hey-frnk/thevfdcollective/FluorescenceCompiled/README.md

# FluorescenceCompiled

Here you will find the latest compiled versions of FluorescenceApp and the firmware of Fluorescence

- FL2:    Fluorescence hardware version 2.x, blue circuit board. Uses Arduino AVR platform, ATmega328P
- FL3:    Fluorescence hardware version 3.x, black circuit board. Uses STM32 platform, STM32L412
