hey-frnk/thevfdcollective/FluorescenceApp/Resources/about.jpg

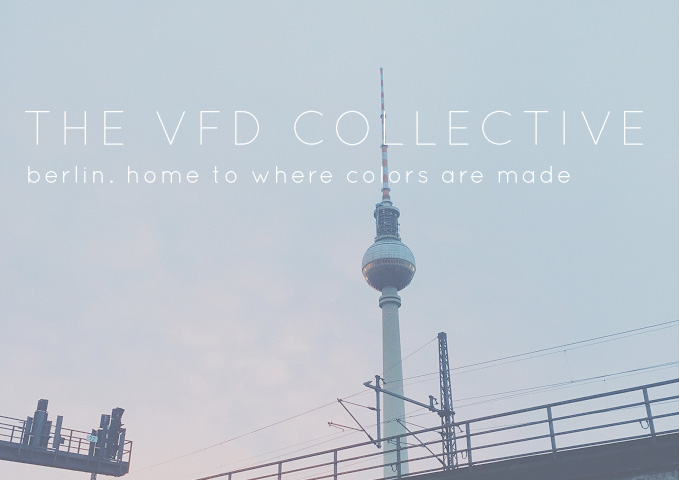
FluorescenceApp/Resources/about.jpg
