hey-frnk/thevfdcollective/FluorescenceApp/Resources/computer.png

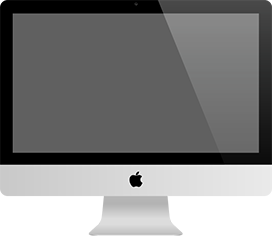
FluorescenceApp/Resources/computer.png
