hey-frnk/thevfdcollective/FluorescenceApp/Resources/fl2_usb.jpg

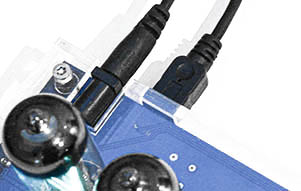
FluorescenceApp/Resources/fl2_usb.jpg
