hey-frnk/thevfdcollective/FluorescenceApp/Resources/fl3_usb.jpg

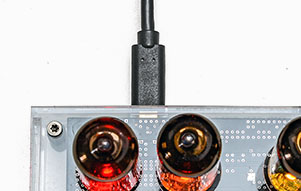
FluorescenceApp/Resources/fl3_usb.jpg
