hey-frnk/thevfdcollective/FluorescenceApp/Resources/menu.png

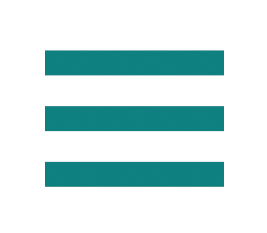
FluorescenceApp/Resources/menu.png
