hey-frnk/thevfdcollective/FluorescenceApp/Resources/menu_inv.png

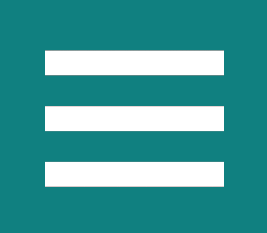
FluorescenceApp/Resources/menu_inv.png
