hey-frnk/thevfdcollective/FluorescenceApp/Resources/pcb.jpg

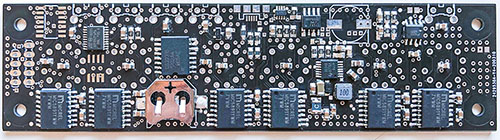
FluorescenceApp/Resources/pcb.jpg
