hey-frnk/thevfdcollective/FluorescenceApp/Resources/reload.png

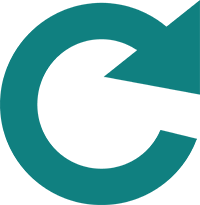
FluorescenceApp/Resources/reload.png
