hey-frnk/thevfdcollective/FluorescenceApp/Resources/res0.jpg

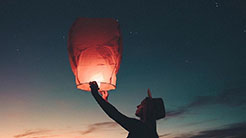
FluorescenceApp/Resources/res0.jpg
