hey-frnk/thevfdcollective/FluorescenceApp/Resources/res1.jpg

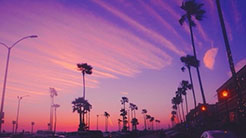
FluorescenceApp/Resources/res1.jpg
