hey-frnk/thevfdcollective/FluorescenceApp/Resources/res2.jpg

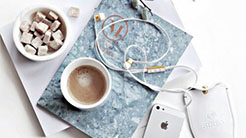
FluorescenceApp/Resources/res2.jpg
