hey-frnk/thevfdcollective/FluorescenceApp/Resources/res3.jpg

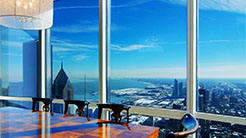
FluorescenceApp/Resources/res3.jpg
