hey-frnk/thevfdcollective/FluorescenceApp/Resources/stop.png

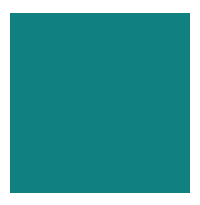
FluorescenceApp/Resources/stop.png
