hey-frnk/thevfdcollective/openvfd_firmware_resources/fw3_architecture.pdf

## OpenVFD / Fluorescence 3.0 Firmware Architecture

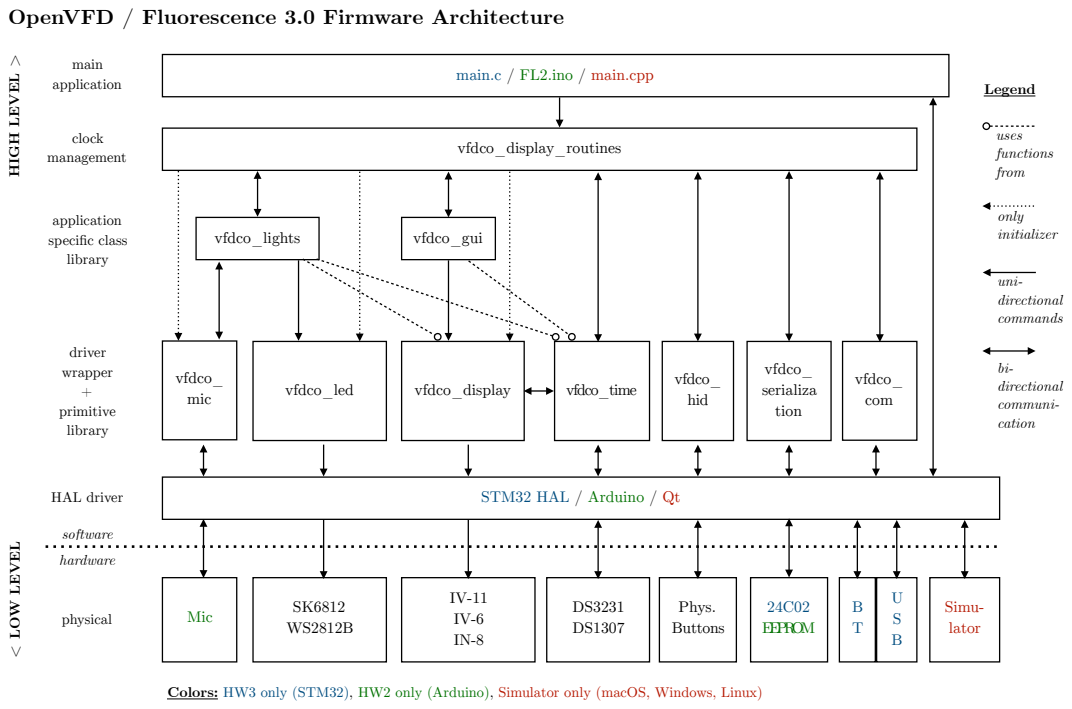
[picture p17: page 1]
vfdco_led; vfdco_display; vfdco_lights; vfdco_gui; vfdco_time; vfdco_; hid; vfdco_display_routines; Phys. Buttons; Simu- lator; vfdco_ com; hardware; software; physical; HAL driver; driver wrapper + primitive library; application specific class library; clock management; main; vfdco_ serializa tion; 24C02 EEPROM; vfdco_ mic; Mic; uses functions from; Legend; only initializer; uni- directional commands; bi- directional communi- cation

HIGH LEVEL > < LOW LEVEL
application

main.c / FL2.ino / main.cpp

STM32 HAL / Arduino / Qt

Colors: HW3 only (STM32), HW2 only (Arduino), Simulator only (macOS, Windows, Linux)
