hey-frnk/thevfdcollective/hardware/eagle_boards/usb_typec_pd_stusb4500.brd

## EAGLE design hardware/eagle_boards/usb_typec_pd_stusb4500.brd (2020-05-08)

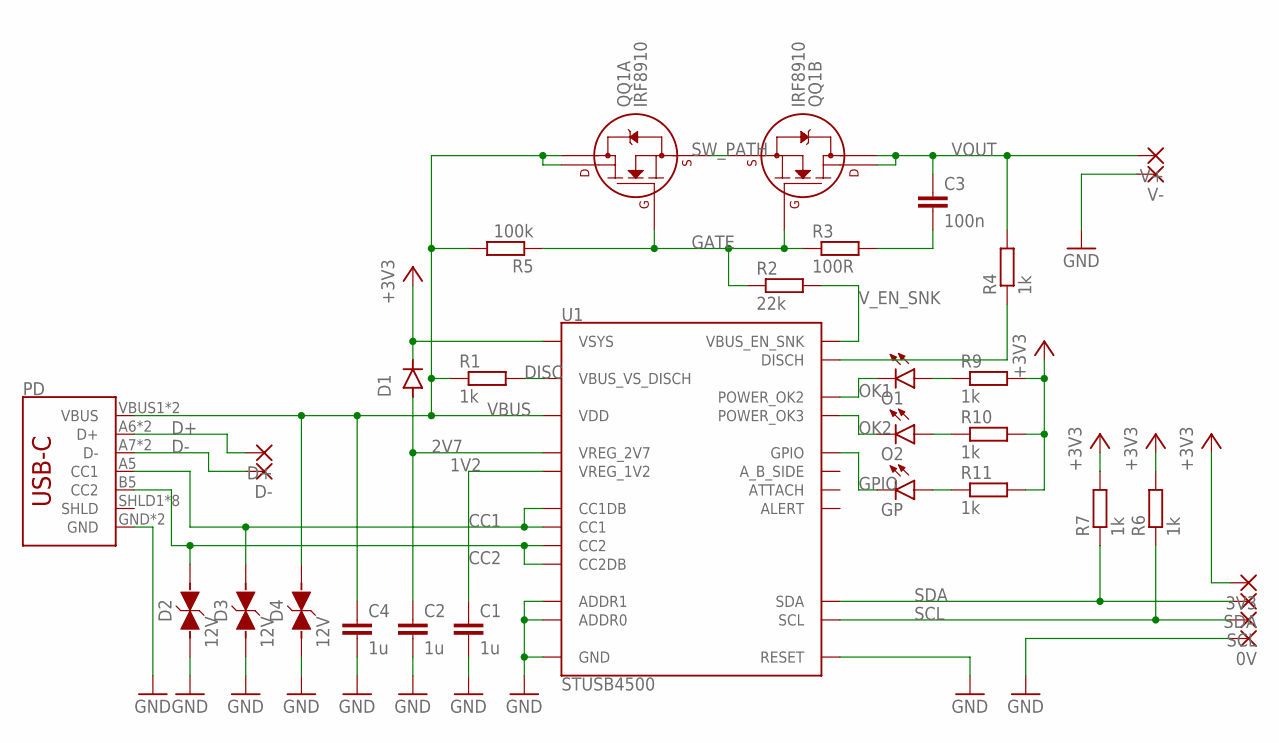
[picture p18: schematic usb_typec_pd_stusb4500.sch]

Parts:
0V, 3V3: SMD2; SMD1,27-2,54
C1, C2, C4: 1u; C0805
C3: 100n; C0805
D1: DIODE-SOD123; SOD123
D2, D3, D4: 12V; WE-VE_0805
D+: SMD2; SMD1,27-2,54
D-: SMD2; SMD1,27-2,54
GP: LEDCHIP-LED0805; CHIP-LED0805
O1, O2: LEDCHIP-LED0805; CHIP-LED0805
PD: USB-TYPEC-16PIN2-LAYER; USB-C-16P
QQ1: IRF8910; SO-8
R1, R4, R6, R7, R9, R10, R11: 1k; R0805
R2: 22k; R0805
R3: 100R; R0805
R5: 100k; R0805
SCL: SMD2; SMD1,27-2,54
SDA: SMD2; SMD1,27-2,54
U1: STUSB4500; POWER-QFN-24
V+: SMD2; SMD1,27-2,54
V-: SMD2; SMD1,27-2,54

Connections:
1V2: C1.1, U1.P$21 (VREG_1V2)
2V7: C2.1, D1.A, U1.P$23 (VREG_2V7)
+3V3: 3V3.1, D1.C, R6.2, R7.2, R9.2, R10.2, R11.2, U1.P$22 (VSYS)
CC1: D3.1, PD.A5 (CC1), U1.P$1 (CC1DB), U1.P$2 (CC1)
CC2: D2.1, PD.B5 (CC2), U1.P$4 (CC2), U1.P$5 (CC2DB)
D+: D+.1, PD.A6 (D+), PD.B6 (D+)
D-: D-.1, PD.A7 (D-), PD.B7 (D-)
DISC: R1.2, U1.P$18 (VBUS_VS_DISCH)
GATE: QQ1.2 (G), QQ1.4 (G), R2.1, R3.1, R5.1
GND: 0V.1, C1.2, C2.2, C4.2, D2.2, D3.2, D4.2, PD.GND, PD.GND2 (GND), U1.P$6 (RESET), U1.P$10 (GND), U1.P$12 (ADDR0), U1.P$13 (ADDR1), U1.P$25 (GND), V-.1
GPIO: GP.C, U1.P$15 (GPIO)
unnamed: C3.2, R3.2
unnamed: R4.1, U1.P$9 (DISCH)
unnamed: O1.A, R9.1
unnamed: O2.A, R10.1
unnamed: GP.A, R11.1
OK1: O1.C, U1.P$20 (POWER_OK2)
OK2: O2.C, U1.P$14 (POWER_OK3)
SCL: R6.1, SCL.1, U1.P$7 (SCL)
SDA: R7.1, SDA.1, U1.P$8 (SDA)
SW_PATH: QQ1.1 (S), QQ1.3 (S)
VBUS: C4.1, D4.1, PD.VBUS1 (VBUS), PD.VBUS2 (VBUS), QQ1.7 (D2), QQ1.8 (D1), R1.1, R5.2, U1.P$24 (VDD)
VOUT: C3.1, QQ1.5 (D2), QQ1.6 (D1), R4.2, V+.1
V_EN_SNK: R2.2, U1.P$16 (VBUS_EN_SNK)

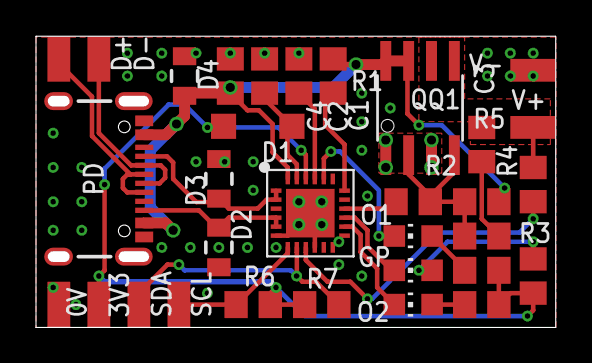
[picture p19: board usb_typec_pd_stusb4500.brd from above]

Board: 2 copper layers, 28.9 x 16.2 mm, 32 parts (0 on the bottom side), 24 nets.
