hey-frnk/thevfdcollective/hardware/eagle_boards/openvfd_ecopower.brd

## EAGLE design hardware/eagle_boards/openvfd_ecopower.brd (2018-04-13)

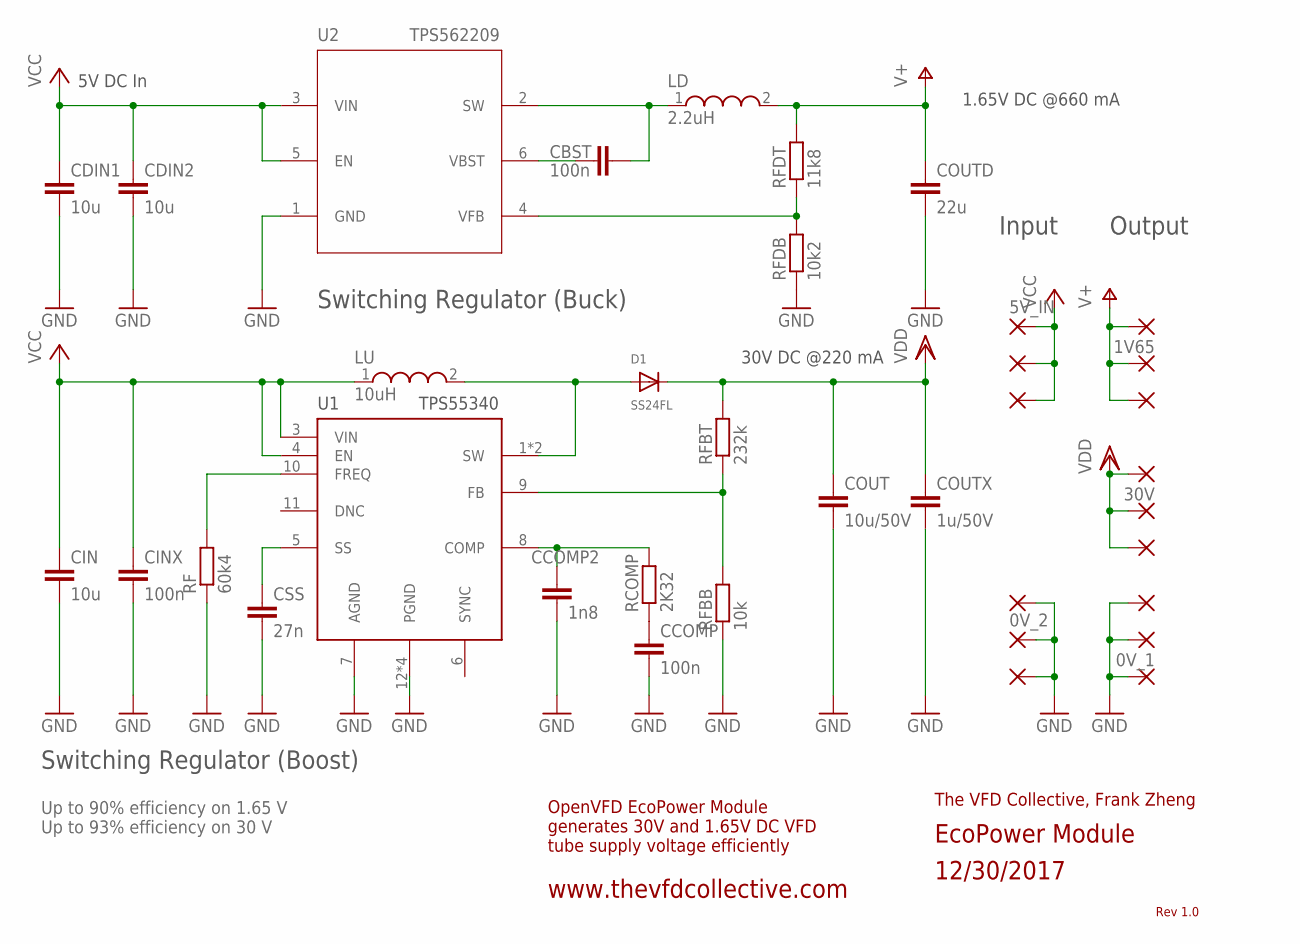
[picture p20: schematic openvfd_ecopower.sch, OpenVFD EcoPower Module]

Parts:
0V_1, 0V_2, 0V_3, 0V_4, 1V1, 1V65, 5V_IN, 5V_IN1, 30V, 30V1: SMD2; SMD1,27-2,54
CBST: 100n; C0805
CCOMP: 100n; C0805
CCOMP2: 1n8; C0805
CDIN1, CDIN2: 10u; C0805
CIN: 10u; C0805
CINX: 100n; C0805
COUT: 10u/50V; C1206
COUTD: 22u; C0805
COUTX: 1u/50V; C0805
CSS: 27n; C0805
D1: SS24FL; SOD-123FL
LD: 2.2uH; WE-TPC_4818/4828
LU: 10uH; WE-LQS_6045
PAD1, PAD2, PAD3, PAD4, PAD5: 1,6/0,8
RCOMP: 2K32; R0805
RF: 60k4; R0805
RFBB: 10k; R0805
RFBT: 232k; R0805
RFDB: 10k2; R0805
RFDT: 11k8; R0805
U1: TPS55340; HTSSOP-14
U2: TPS562209; SOT-23(6)

Connections:
COMP: CCOMP2.1, RCOMP.2, U1.8 (COMP)
FB: RFBB.2, RFBT.1, U1.9 (FB)
FREQ: RF.2, U1.10 (FREQ)
GND: 0V_1.1, 0V_2.1, 0V_3.1, 0V_4.1, CCOMP.2, CCOMP2.2, CDIN1.2, CDIN2.2, CIN.2, CINX.2, COUT.2, COUTD.2, COUTX.2, CSS.2, PAD1.1, PAD5.1, RF.1, RFBB.1, RFDB.1, U1.7 (AGND), U1.12 (PGND), U1.13 (PGND), U1.14 (PGND), U1.15 (PGND), U2.1 (GND)
unnamed: CCOMP.1, RCOMP.1
unnamed: CBST.1, U2.6 (VBST)
unnamed: RFDB.2, RFDT.1, U2.4 (VFB)
SS: CSS.1, U1.5 (SS)
SW: D1.A, LU.2, U1.1 (SW), U1.2 (SW)
V+: 1V1.1, 1V65.1, COUTD.1, LD.2, PAD3.1, RFDT.2
VCC: 5V_IN.1, 5V_IN1.1, CDIN1.1, CDIN2.1, CIN.1, CINX.1, LU.1, PAD2.1, U1.3 (VIN), U1.4 (EN), U2.3 (VIN), U2.5 (EN)
VDD: 30V.1, 30V1.1, COUT.1, COUTX.1, D1.C, PAD4.1, RFBT.2
VSW_D: CBST.2, LD.1, U2.2 (SW)

Notes on the sheet:
Input
Output
30V DC @220 mA
1.65V DC @660 mA
EcoPower Module
12/30/2017
5V DC In
Up to 90% efficiency on 1.65 V Up to 93% efficiency on 30 V
Rev 1.0
OpenVFD EcoPower Module generates 30V and 1.65V DC VFD tube supply voltage efficiently
www.thevfdcollective.com
The VFD Collective, Frank Zheng
Switching Regulator (Buck)
Switching Regulator (Boost)

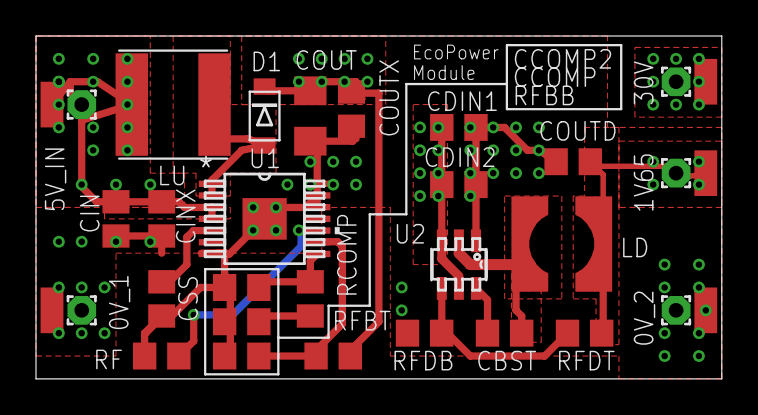
[picture p21: board openvfd_ecopower.brd from above]

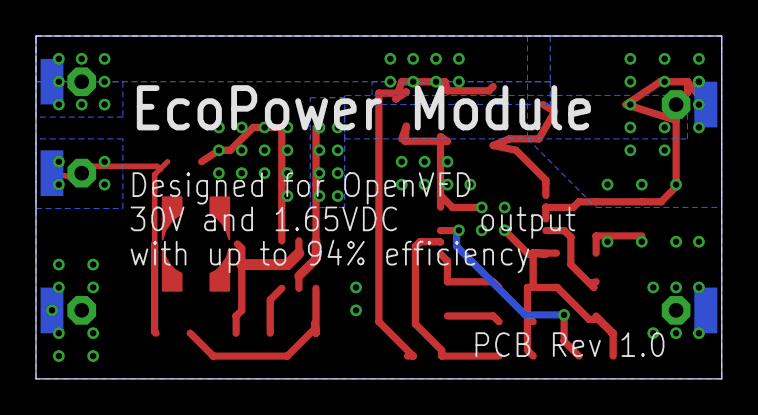
[picture p22: board openvfd_ecopower.brd from below]

Board: 2 copper layers, 38.1 x 19.1 mm, 37 parts (5 on the bottom side), 13 nets.
