hey-frnk/thevfdcollective/FluorescenceV3/FL3/FL3.ioc

Mcu.UserName=STM32L412K8Tx
PA0-CK_IN.GPIO_Label=LED_PIN
PA0-CK_IN.Signal=S_TIM2_CH1
PA1.Signal=SPI1_SCK
PA10.Signal=I2C1_SDA
PA11.Signal=USB_DM
PA12.Signal=USB_DP
PA2.Signal=USART2_TX
PA3.Signal=USART2_RX
PA4.GPIO_Label=SPI1_NSS
PA4.Signal=GPIO_Output
PA5.Signal=ADCx_IN10
PA6.Signal=ADCx_IN11
PA7.Signal=SPI1_MOSI
PA9.Signal=I2C1_SCL
PB0.GPIO_Label=HV_SW
PB0.Signal=GPIO_Output
PB1.GPIO_Label=HV_SW1
PB1.Signal=GPIO_Output
PB5.GPIO_Label=F1
PB5.Signal=GPIO_Input
PB6.GPIO_Label=F2
PB6.Signal=GPIO_Input
PB7.GPIO_Label=F3
PB7.Signal=GPIO_Input
