hey-frnk/thevfdcollective/FluorescenceV3/FL3/Src/main.c

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
/* Includes ------------------------------------------------------------------*/
#include "main.h"
#include "usb_device.h"

/* USER CODE BEGIN Includes */
#include "../../Commons/vfdco_clock_routines.h"
/* USER CODE END Includes */

/* USER CODE BEGIN PD */
#define USB_DEF_L 310
#define USB_DEF_H 757
#define USB_1A5_L 868
#define USB_1A5_H 1440
#define USB_3A0_L 1625
#define USB_3A0_H 2531

#define BOOTLOADER_FLAG_VALUE 0x00C0FFEE
#define BOOTLOADER_FLAG_OFFSET 50
#define BOOTLOADER_ADDRESS 0x1FFF0000 // AN2606 Table 150
/* USER CODE END PD */

 ADC_HandleTypeDef hadc1;
DMA_HandleTypeDef hdma_adc1;

I2C_HandleTypeDef hi2c1;

SPI_HandleTypeDef hspi1;
DMA_HandleTypeDef hdma_spi1_tx;

TIM_HandleTypeDef htim2;
TIM_HandleTypeDef htim16;
DMA_HandleTypeDef hdma_tim2_ch1;

UART_HandleTypeDef huart2;

/* USER CODE BEGIN PV */

// Switch variable between two ADC channels for CC1 and CC2 of USB Type C input
uint32_t adc_channel = ADC_CHANNEL_1;
// Stores ADC readout values for CH1 and CH2
volatile uint32_t ch1_in = 0, ch2_in = 0;
uint32_t adc_ch[2];

typedef enum {
  USB_CC_VOLTAGE_OUT_OF_RANGE,
  USB_CC_VOLTAGE_DEFAULT,
  USB_CC_VOLTAGE_1A5,
  USB_CC_VOLTAGE_3A0
} USB_CC_VOLTAGE_t;

/* USER CODE END PV */

void SystemClock_Config(void);
static void MX_GPIO_Init(void);
static void MX_DMA_Init(void);
static void MX_ADC1_Init(void);
static void MX_I2C1_Init(void);
static void MX_SPI1_Init(void);
static void MX_TIM2_Init(void);
static void MX_TIM16_Init(void);
static void MX_USART2_UART_Init(void);
/* USER CODE BEGIN PFP */

static USB_CC_VOLTAGE_t check_usb_cc(uint_fast16_t cc_voltage);

/* USER CODE END PFP */

/**
  * @brief  The application entry point.
  * @retval int
  */
int main(void)
{
  /* MCU Configuration--------------------------------------------------------*/

  /* Reset of all peripherals, Initializes the Flash interface and the Systick. */
  HAL_Init();

  /* Configure the system clock */
  SystemClock_Config();

  /* Initialize all configured peripherals */
  MX_GPIO_Init();
  MX_DMA_Init();
  MX_ADC1_Init();
  MX_I2C1_Init();
  MX_SPI1_Init();
  MX_TIM2_Init();
  MX_TIM16_Init();
  MX_USART2_UART_Init();
  MX_USB_DEVICE_Init();
  /* USER CODE BEGIN 2 */

  // Start CC read in
  HAL_ADC_Start_DMA(&hadc1, adc_ch, 2);
  HAL_Delay(10);
  USB_CC_VOLTAGE_t cc_status_setup = check_usb_cc((ch1_in > ch2_in) ? ch1_in : ch2_in);

  // Boot!
  if(cc_status_setup == USB_CC_VOLTAGE_OUT_OF_RANGE || cc_status_setup == USB_CC_VOLTAGE_DEFAULT) {
    // At startup, do not turn on if weak power source is present. Instead welcome with low power lights
    HAL_GPIO_WritePin(HV_SW_GPIO_Port, HV_SW_Pin, GPIO_PIN_RESET);
    // Initialize clock
    vfdco_clock_initializer(0x00440000); // Green progress bar as welcome message!
  } else /*if(cc_status_setup == USB_CC_VOLTAGE_1A5 || cc_status_setup == USB_CC_VOLTAGE_3A0)*/ {
    HAL_GPIO_WritePin(HV_SW_GPIO_Port, HV_SW_Pin, GPIO_PIN_SET);
    // Initialize clock
    vfdco_clock_initializer(0x00000000); // No progress
  }

  /* USER CODE END 2 */

  /* Infinite loop */
  /* USER CODE BEGIN WHILE */
  while (1)
  {
    /* USER CODE END WHILE */

    /* USER CODE BEGIN 3 */

    // Monitor CC voltage
    USB_CC_VOLTAGE_t cc_status_loop = check_usb_cc((ch1_in > ch2_in) ? ch1_in : ch2_in);
    switch(cc_status_loop) {
      case USB_CC_VOLTAGE_OUT_OF_RANGE: HAL_GPIO_WritePin(HV_SW_GPIO_Port, HV_SW_Pin, GPIO_PIN_RESET); break;
      // At runtime, turn on despite weak source, and pray for the port to supply up to 0.9A lol which is no problem 99% of the time
      case USB_CC_VOLTAGE_DEFAULT:      HAL_GPIO_WritePin(HV_SW_GPIO_Port, HV_SW_Pin, GPIO_PIN_SET); break;
      case USB_CC_VOLTAGE_1A5:          HAL_GPIO_WritePin(HV_SW_GPIO_Port, HV_SW_Pin, GPIO_PIN_SET); break;
      case USB_CC_VOLTAGE_3A0:          HAL_GPIO_WritePin(HV_SW_GPIO_Port, HV_SW_Pin, GPIO_PIN_SET); break;
    }

  	// WoHOo hOw FuN iS tHhIis??
  	vfdco_clock_routine();

  	// Update IWDG
  	// HAL_IWDG_Refresh(&hiwdg);
  }
  /* USER CODE END 3 */
}

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
/* USER CODE BEGIN 4 */
/**
 * @brief This function detects the USB Type C CC pin voltage and switches on the HV parts depending on the maximum power
 * offered by the upstream source (or cable, if USB 2.0/3.0 legacy). It is implemented according to
 * Table 4-36 'Voltage on Sink CC pins (Multiple Source Current Advertisements)' in USB Type-C Specification R2.0 - August 2019
 * @param cc_voltage CC voltage analog input value from ADC channels
 * @return USB CC detected, according to USB_CC_VOLTAGE_t
 */
static USB_CC_VOLTAGE_t check_usb_cc(uint_fast16_t cc_voltage) {
	if(cc_voltage >= USB_DEF_L && cc_voltage <= USB_DEF_H) {
    return USB_CC_VOLTAGE_DEFAULT;
	} else if(cc_voltage >= USB_1A5_L && cc_voltage <= USB_1A5_H) {
    return USB_CC_VOLTAGE_1A5;
	} else if(cc_voltage >= USB_3A0_L && cc_voltage <= USB_3A0_H) {
    return USB_CC_VOLTAGE_3A0;
	} else {
    return USB_CC_VOLTAGE_OUT_OF_RANGE;
	}
}

/**
 * @brief ADC conversion complete callback. If the ADC read in has completed
 * @param hadc 
 */
void HAL_ADC_ConvCpltCallback(ADC_HandleTypeDef* hadc) {
	/*ADC_ChannelConfTypeDef sConfig;
	if(adc_channel == ADC_CHANNEL_10) {
		ch1_in = HAL_ADC_GetValue(hadc);
		sConfig.Rank = ADC_REGULAR_RANK_1;
		sConfig.Channel = ADC_CHANNEL_11;
		HAL_ADC_ConfigChannel(hadc, &sConfig);
		adc_channel = ADC_CHANNEL_11;
	} else {
		ch2_in = HAL_ADC_GetValue(hadc);
		sConfig.Rank = ADC_REGULAR_RANK_1;
		sConfig.Channel = ADC_CHANNEL_10;
		HAL_ADC_ConfigChannel(hadc, &sConfig);
		adc_channel = ADC_CHANNEL_10;
	}
	HAL_ADC_Start_IT(hadc);*/
	ch1_in = adc_ch[0];
	ch2_in = adc_ch[1];
}

extern volatile uint32_t _bootloader_flag;
/**
 * @brief Write dirty bit and go into DFU mode bootloader
 * @param bootloader_status 
 */
void activate_bootloader(uint32_t bootloader_status) {
	if(bootloader_status == 1) {
		// Write DFU message
		uint8_t dfu_msg[6] = {0x00, 0x00, 0x00, 0x7C, 0x8E, 0x7A};
		NVIC_DisableIRQ(TIM1_UP_TIM16_IRQn);
		HAL_SPI_Transmit(&hspi1, dfu_msg, CONFIG_NUM_DIGITS, 40);
		HAL_GPIO_WritePin(GPIOA, GPIO_PIN_4, GPIO_PIN_SET);
		HAL_GPIO_WritePin(GPIOA, GPIO_PIN_4, GPIO_PIN_RESET);
		NVIC_EnableIRQ(TIM1_UP_TIM16_IRQn);
		// Disable interrupts
		__disable_irq();
		// http://blog.fahhem.com/2017/12/jump-to-emb-bootloader/
		_bootloader_flag = BOOTLOADER_FLAG_VALUE; // Magic number flag set
		// See you latte
		NVIC_SystemReset();

	  while(1);
	}
}


/* USER CODE END 4 */
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
