hey-frnk/thevfdcollective/FluorescenceV3/FL3/Inc/main.h

#define LED_PIN_Pin GPIO_PIN_0
#define LED_PIN_GPIO_Port GPIOA
#define SPI1_NSS_Pin GPIO_PIN_4
#define SPI1_NSS_GPIO_Port GPIOA
#define HV_SW_Pin GPIO_PIN_0
#define HV_SW_GPIO_Port GPIOB
#define HV_SW1_Pin GPIO_PIN_1
#define HV_SW1_GPIO_Port GPIOB
#define F1_Pin GPIO_PIN_5
#define F1_GPIO_Port GPIOB
#define F2_Pin GPIO_PIN_6
#define F2_GPIO_Port GPIOB
#define F3_Pin GPIO_PIN_7
#define F3_GPIO_Port GPIOB
#define F4_Pin GPIO_PIN_3
#define F4_GPIO_Port GPIOH
