hey-frnk/thevfdcollective/FluorescenceApp/main.cpp

#include "fluorescenceapp.h"

#include <QApplication>
#include <QFontDatabase>
#include <QLayout>

int main(int argc, char *argv[])
{
    // QGuiApplication::setAttribute(Qt::AA_EnableHighDpiScaling); // No longer required

    QApplication a(argc, argv);
    qDebug() << QFontDatabase::addApplicationFont(QStringLiteral(":/Resources/RalewayBlack.ttf"));
    qDebug() << QFontDatabase::addApplicationFont(QStringLiteral(":/Resources/RalewayBold.ttf"));
    qDebug() << QFontDatabase::addApplicationFont(QStringLiteral(":/Resources/RalewayMedium.ttf"));

    FluorescenceApp w;

    // Fix size and disable maximizing (update: freely resizable now!)
    // w.setWindowFlags(Qt::Window | Qt::CustomizeWindowHint | Qt::WindowTitleHint | Qt::WindowSystemMenuHint | Qt::WindowMinimizeButtonHint | Qt::WindowCloseButtonHint);
    #ifndef Q_OS_IOS
    w.setMinimumSize(640, 440);
    w.resize(w.minimumSize());
    #endif

    w.show();

    return a.exec();
}
