hey-frnk/thevfdcollective/FluorescenceApp/fwupdate.h

#ifndef FWUPDATESTM_H
#define FWUPDATESTM_H

#include <QDialog>
#ifndef Q_OS_IOS
#include <QProcess>
#endif

typedef enum {
  FIRMWARE_UPDATE_UNDETERMINED,
  FIRMWARE_UPDATE_STM,
  FIRMWARE_UPDATE_AVR
} fw_updater_t;

namespace Ui {
class FWUpdate;
}

class FWUpdate : public QDialog
{
    Q_OBJECT

public:
    explicit FWUpdate(QWidget *parent = nullptr, QString fw_string = QString(), QString port_name = QString());
    ~FWUpdate();

signals:
    void readyReadStandardOutput();
    void readyReadStandardError();

private slots:
    void on_welcome_next_clicked();

    void on_updater_run_clicked();

    void on_updater_agree_stateChanged(int arg1);

    void on_updater_update_clicked();

    void ReadOut();
    void ReadErr();
    #ifndef Q_OS_IOS
    void UpdateFinished(int exitCode, QProcess::ExitStatus exitStatus);
    #endif

private:
    void execute_updater(QString command, QStringList command_args, fw_updater_t updater_type);

    Ui::FWUpdate *ui;
    fw_updater_t fw_updater_type_detected;
    QString fw_updater_path_detected, fw_updater_firmware_file_detected;

    QString fw_string, port_name;
};

#endif // FWUPDATESTM_H
