hey-frnk/thevfdcollective/FluorescenceApp/clickablelabel.cpp

#include <QMouseEvent>
#include "clickablelabel.h"

ClickableLabel::ClickableLabel(QWidget* parent, Qt::WindowFlags f)
    : QLabel(parent, f) {
}

ClickableLabel::~ClickableLabel() {}

void ClickableLabel::mousePressEvent(QMouseEvent* event) {
    emit clicked();

    const QPoint p = event->pos();
    offset = p;
    emit mousePressed(p);
}
