hey-frnk/thevfdcollective/FluorescenceApp/clickablelabel.h

#ifndef CLICKABLELABEL_H
#define CLICKABLELABEL_H

#include <QLabel>
#include <QWidget>
#include <Qt>

class ClickableLabel : public QLabel {
    Q_OBJECT

public:
    explicit ClickableLabel(QWidget* parent = Q_NULLPTR, Qt::WindowFlags f = Qt::WindowFlags());
    ~ClickableLabel();

signals:
    void clicked();
    void mousePressed(const QPoint&);

protected:
    void mousePressEvent(QMouseEvent* event);

private:
    QPoint offset;
};

#endif // CLICKABLELABEL_H
