hey-frnk/thevfdcollective/(commit log)

2018-04-13 OpenVFD eagle files, library added
    [openvfd_ecopower.brd, openvfd_ecopower.sch, openvfd_r2_1_fluorescence.sch]
2018-04-16 v2.21 release: bug fix
    [openvfd_firmware.ino]
2018-04-22 OpenVFD Rev 3 Development Files
    [OpenVFD_freeS.brd, OpenVFD_freeS.sch]
2018-04-25 FreeS .brd updated
    [OpenVFD_freeS.brd, OpenVFD_freeS.sch]
2018-04-28 FreeS Update
    [OpenVFD_freeS.brd, OpenVFD_freeS.sch]
2018-05-09 Board update
    [OpenVFD_freeS.brd]
2018-07-24 FW Version 3 Development
    [OpenVFD_freeS.brd]
2018-08-12 V3 development, STM32F0
2019-01-13 Arduino test drive
2019-11-19 SK6812 STM32F0XX Driver added, in dev state
    [FLClassic Run.cfg]
2019-12-22 Fix The Bug Fug The Bix
    [vfdco_sk6812.c, vfdco_time.c]
2020-02-02 fixed some pretty awkward bugs. color discontinuity problems solved, Fader memory optimizations
    [vfdco_config.h, vfdco_lights.c, vfdco_lights.h, vfdco_sk6812.c, vfdco_time.c]
2020-02-16 SPI now using DMA, display and lights dimmable. Next: An magnificent night shift like never before
2020-02-16 SPI now using DMA, display and lights dimmable. Next: A magnificent night shift like never before
2020-03-10 Dev of Arduino FL2.0 version
2020-03-10 FL 3.0 Firmware ported to Arduino. Should not work at this point
    [FL2.ino, vfdco_clock_routines.c, vfdco_clock_routines.h, vfdco_com.cpp, vfdco_com.h, vfdco_config.h, vfdco_config_hw2.h, vfdco_config_sim.h]
2020-03-24 Fluorescence Simulator
    [protocol.csv]
2020-03-25 Bug fix: Clear definitions of rgb_arr length, LED protocol length and LED instance length
    [vfdco_clock_routines.c, vfdco_config.h, vfdco_config_sim.h, vfdco_hid.c, vfdco_led.h, vfdco_lights.c, vfdco_lights.h]
2020-03-28 Docu Update
    [protocol.csv]
2020-04-02 Bug fixed that would cause hsl2rgb to perform in undefined behavior on HW2 platform
    [vfdco_clock_routines.c, vfdco_config.h, vfdco_config_hw2.h, vfdco_lights.c]
2020-04-12 A lot of changes. Moved fw_dev to FL3
    [FLClassic Run.cfg, protocol.csv]
2020-04-13 Fixed a bug that cause the dimmer of FL2 not to work
    [fl_app_com.cpp, fluorescenceapp.cpp, vfdco_clock_routines.c, vfdco_com.cpp]
2020-04-19 DFU Mode for STM32 FL
    [FLClassic_USB.cfg]
2020-04-22 FL Dainty First run -> works!
    [FLDainty Debug.cfg]
2020-04-25 Better documentation. yay.
    [protocol.csv]
2020-05-04 lights: f3var implemented in single color to reverse rainbow
    [vfdco_config.h, vfdco_lights.c]
2020-05-08 USB Type C PD breakout board, Eagle files updated
    [OpenVFD_freeS.brd, OpenVFD_freeS.sch, openvfd_ecopower.brd, openvfd_ecopower.sch, openvfd_ecopower_compact.brd, openvfd_ecopower_compact.sch, openvfd_r2_1_fluorescence.sch, usb_typec_pd_stusb4500.brd]
2020-05-11 USB Type C CC voltage monitoring, LTO optimized code is buggy, TODO welcome msg for Arduino
    [main.c, main.h, vfdco_clock_routines.c, vfdco_clock_routines.h, vfdco_config.h, vfdco_gui.c, vfdco_lights.c, vfdco_sk6812.c]
2020-05-16 Merged FLClassic & FLDainty into FL3 (HW independent), STM32F042 -> STM32L421 for more power
    [FL3 Debug.cfg, FLClassic Run.cfg, FLClassic_USB.cfg, FLDainty Debug.cfg]
2020-06-11 ADC fixed
2020-09-18 Bluetooth for FluorescenceApp: Responses from Fluorescence now work correctly
    [fl_app_com.cpp, fl_app_com.h, vfdco_clock_routine_defines.h, vfdco_clock_routines.c, vfdco_clock_routines.h, vfdco_com.cpp, vfdco_com.h, vfdco_config.h]
2020-09-21 Bluetooth Communication is working with FL3 (STM32L4)
2020-10-11 FluorescenceApp Firmware update is also implemented for FL3 (STM32) now
2020-10-13 FluorescenceApp communicates with firmware version 2 without issues now. Also, updating from V2 has been tested and is working
    [fl_app_com.cpp, fl_app_com.h, fluorescenceapp.cpp, fluorescenceapp.h, fwupdate.cpp, main.cpp]
2020-10-14 Critical BT communication issues fixed; Load and save colors in FluorescenceApp
    [FL3.ioc, fl_app_com.cpp, fluorescenceapp.cpp, fluorescenceapp.h, main.c, vfdco_com.c]
2020-10-15 FL3: Fixed an issue that would cause a hardware reset to get stuck in DFU
    [FL3.ioc, fwupdate.cpp, main.c, vfdco_clock_routines.c, vfdco_config_hw3.h]
2020-10-23 FluorescenceApp: Fixed a bug that causes a incoming serial data to be read incorrectly
    [fl_app_com.cpp, fluorescenceapp.cpp, main.cpp]
2020-10-23 FluorescenceApp: Hopefully fixed scaling on Windows; added setting time for a different time zone or universe
    [fluorescenceapp.cpp, fluorescenceapp.h]
2020-10-23 FluorescenceApp: Updating FL2 from Windows now works properly. Todo: FL3 with dfu util on Windows still bricks device; Bluetooth still doesn't work
    [fl_app_com.cpp, fwupdate.cpp]
2020-12-22 STM32L412KB -> STM32L412K8 formally migrated. Ready for release
2025-05-01 * Updated to STM32CubeMX 6.5 and migrated project to STM32CubeIDE * New feature: FINALLY!! Cross-fade and blend-fade between digits * New feature: WOHOO!! New light pattern: Pulsed cross fade * Bug f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
    [FL3.ioc, main.c, main.h, vfdco_clock_routine_defines.h, vfdco_clock_routines.c, vfdco_config.h, vfdco_config_hw2.h]
