hey-frnk/thevfdcollective/(notices)

Notices in the files:
FluorescenceV3/FL3/Src/main.c:
© Copyright (c) 2020 STMicroelectronics.
All rights reserved.
This software component is licensed by ST under Ultimate Liberty license
parts and their libraries:
Wurth_Elektronik_Passive_rev15b: Copyright: Würth Elektronik
